xzqiaochu/CableMeasure/Schematic_同轴电缆长度与终端负载检测装置.pdf

## ADJ/GND

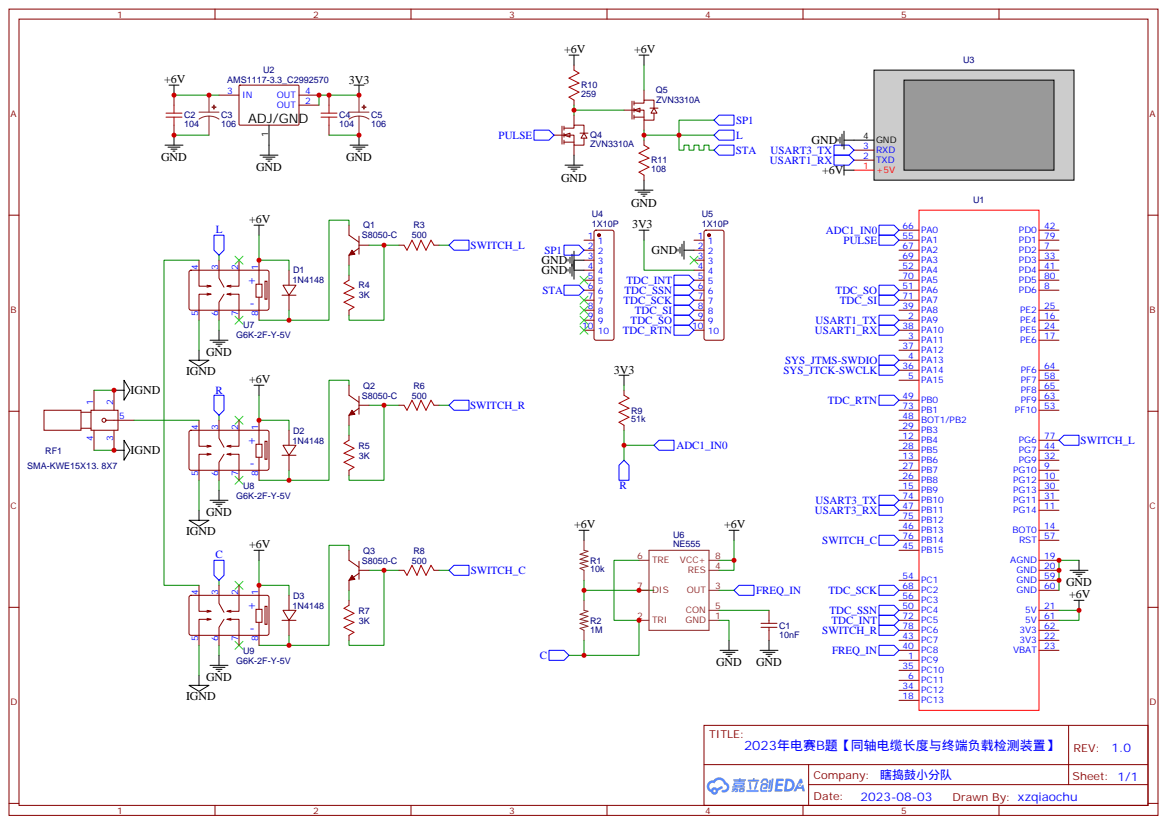
[picture p9: page 1]
