xzqiaochu/CableMeasure/CableMeasure/Core/Inc/main.h

#define LED1_Pin GPIO_PIN_3
#define LED1_GPIO_Port GPIOE
#define TDC_SCK_Pin GPIO_PIN_2
#define TDC_SCK_GPIO_Port GPIOC
#define PULSE_Pin GPIO_PIN_1
#define PULSE_GPIO_Port GPIOA
#define TDC_SO_Pin GPIO_PIN_6
#define TDC_SO_GPIO_Port GPIOA
#define TDC_SI_Pin GPIO_PIN_7
#define TDC_SI_GPIO_Port GPIOA
#define TDC_SSN_Pin GPIO_PIN_4
#define TDC_SSN_GPIO_Port GPIOC
#define TDC_INT_Pin GPIO_PIN_5
#define TDC_INT_GPIO_Port GPIOC
#define TDC_RTN_Pin GPIO_PIN_0
#define TDC_RTN_GPIO_Port GPIOB
#define SWITCH_C_Pin GPIO_PIN_14
#define SWITCH_C_GPIO_Port GPIOB
#define SWITCH_L_Pin GPIO_PIN_6
#define SWITCH_L_GPIO_Port GPIOG
#define SWITCH_R_Pin GPIO_PIN_6
#define SWITCH_R_GPIO_Port GPIOC
#define FREQ_IN_Pin GPIO_PIN_8
#define FREQ_IN_GPIO_Port GPIOC
#define FREQ_IN_EXTI_IRQn EXTI9_5_IRQn
